TheVaccin3/IDP/Milestone 3 Report.pdf

Saksham Goyal
Jeff Kedda

# Milestone 3 Report

## Integrated Design Project (Audio Direction Finding)

## Objective

The objective for this milestone is to generate an equation for the angle between the microphones and the speaker. Another goal for this week was to implement this equation into code and incorporate the code into the hardware part of our project.

## Results and Analysis

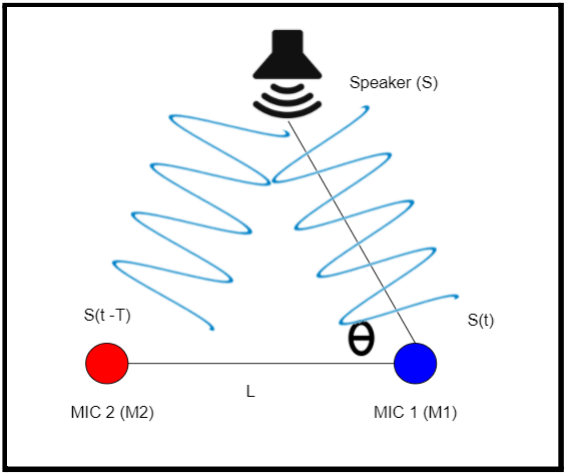
[picture p15: figure]

### Figure 1

This figure shows the system of the two microphones and the speaker. Even though Mic 1 (M1) is closer to the speaker the signals obtained by both microphones should have an equal amplitude but should have a delay in time. The time difference between these two microphones will be represented by T. Therefore, the signal captured by M1 is S(t) and M2 is S(t-T).

### Figure 2

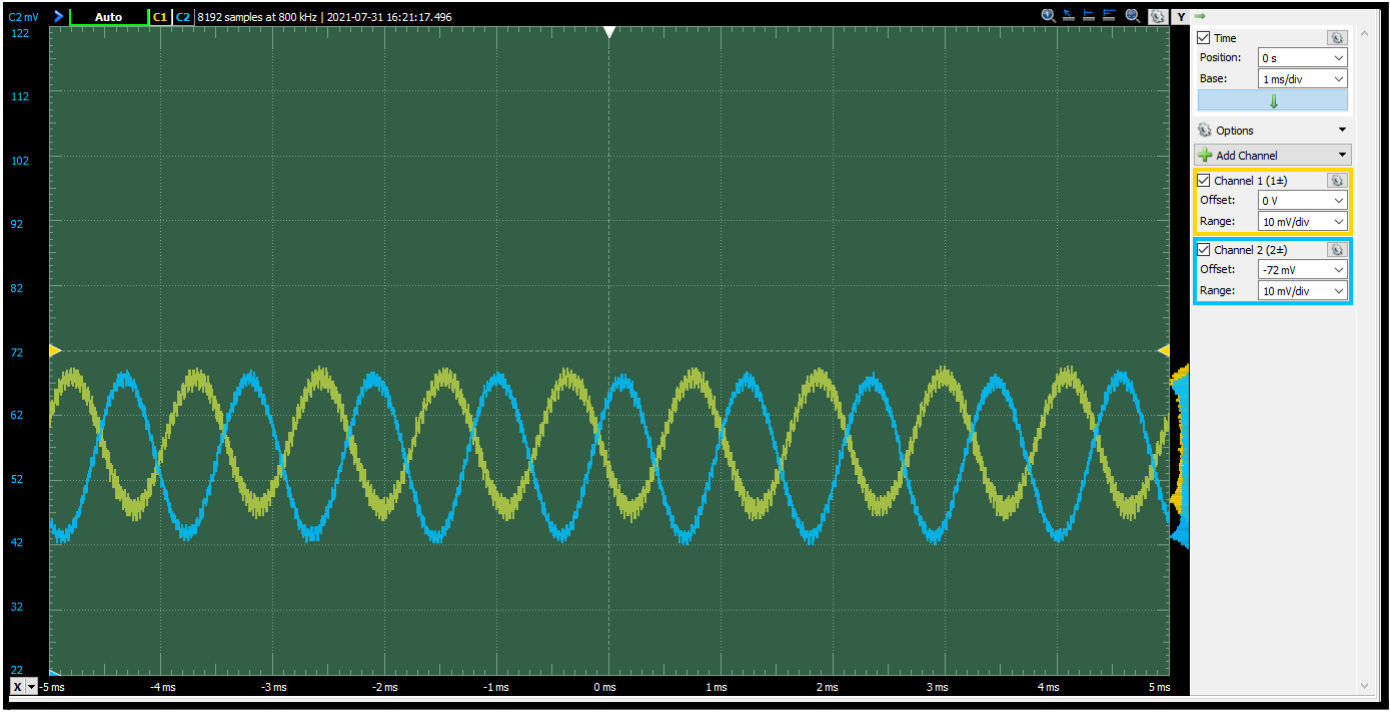
[picture p16: figure]

From the two microphones, figure 2 shows the phase and time difference between the two signals when the speaker is playing a 900 Hz tone.

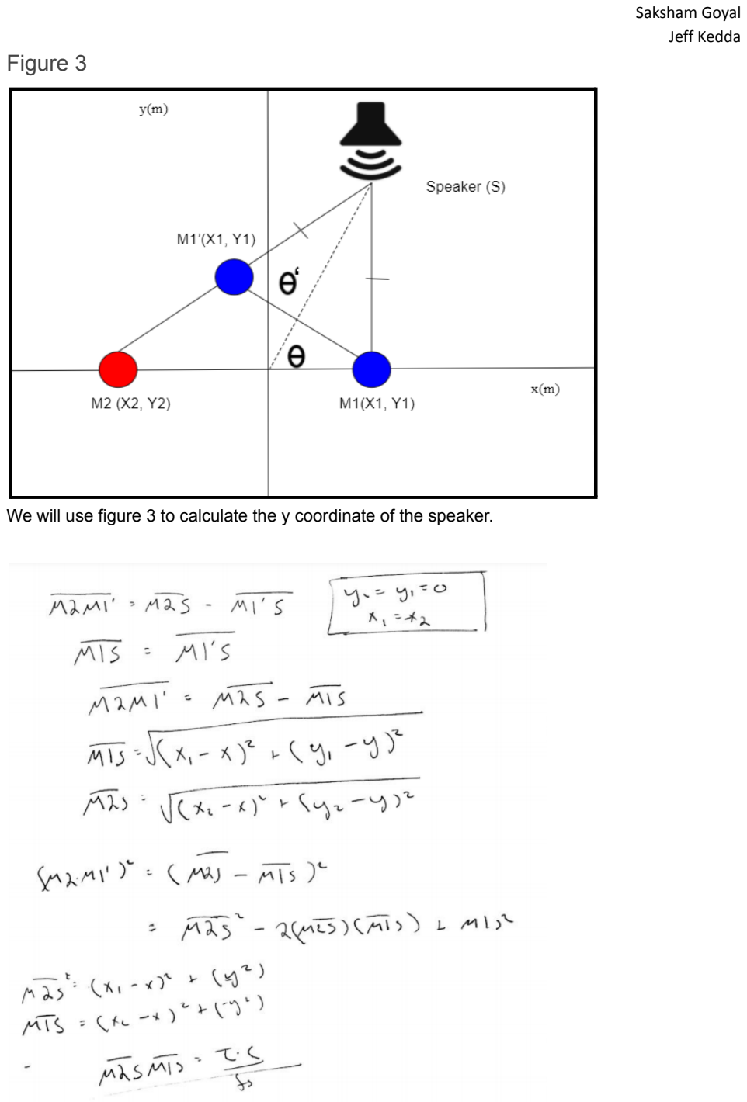
[picture p17: page 3]

### Figure 3

We will use figure 3 to calculate the y coordinate of the speaker.

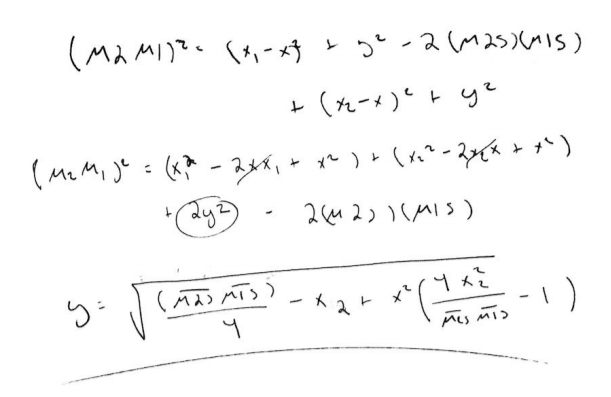
[picture p18: figure]

y = | ((M
| 2

S)(M
1

S)/4 − X

2 + X

2
((4X
2

2
)/(M
2

S)(M
1

S) − 1)

At the end of the calculation, we get the formula above for the y-coordinate of the speaker.

## Real Testing

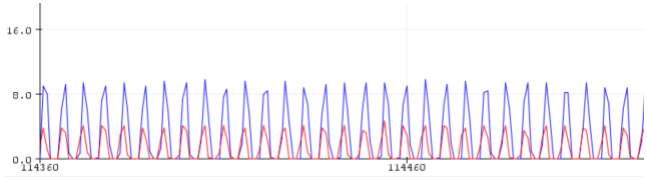
[picture p19: figure]

We tested the circuit on the arduino and recorded the output of the circuit using the arduino serial plotter. We used a very high baud rate to make sure no data was lost. We can very clearly see that when the source is placed in line with the 2 mics, the phase angle looks to be 0 since the peaks are aligned.

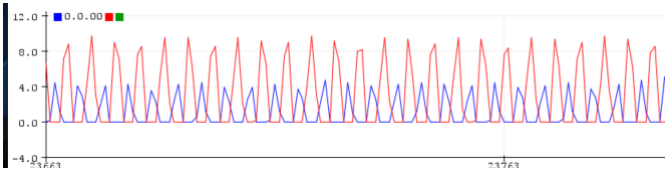
[picture p20: figure]

We then placed the source at the other end of the line and we saw that the peaks were opposite each other showing that they were 180 degrees apart which is exactly what we wanted.

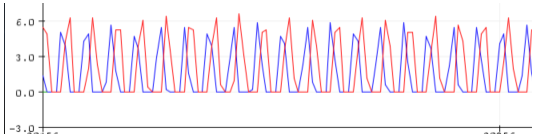
[picture p21: figure]

Placing it at 90 degrees (in between the 2 mics) showed a 90 degree shift (the blue signal peaks when the red signal is about to rise, and the red peaks when the blue reaches 0). This means that we could find the angle of the source directly by finding the phase shift in the signal. This also means that for the particular setup we have, the distance between the 2 mics, and the speed of sound is entirely irrelevant.

We are not sure why this works, or if I am interpreting this data incorrectly, but right now it seems like its working better than expected. However, once more code is programmed, this might change since more code might change certain aspects of the speed of the program which could affect the phase of the plots.

## Plans For Next Week

The plan for next week is figuring out how to sample and find the phase through the Arduino. We still need to code and finish the calculations.

Author Recognition
Jeff Kedda - Y coordinate calculation and phase difference between the two microphones Saksham Goyal - Real circuit testing with arduino and plotting data from arduino output.
